sarahemm/laserbox/lasercut_parts/README.md

This directory holds design files for laser cut parts.

prod - Production files to cut actual parts.
test - Test files to cut parts used for testing but not in the final project.
planning - Files used for planning the project, not for actual CAM.
