sarahemm/laserbox/3d/anim_multi.scad

// animation frame data for demo 4
multiframes_circlemissing = [
    [/*[4,3], [4,4],*/ [5,5], [6,6], [7,6], [8,5], [9,4], [9,3], [8,2], [7,1], [6,1], [5,2]],
    [[4,3], /*[4,4], [5,5],*/ [6,6], [7,6], [8,5], [9,4], [9,3], [8,2], [7,1], [6,1], [5,2]],
    [[4,3], [4,4], /*[5,5], [6,6],*/ [7,6], [8,5], [9,4], [9,3], [8,2], [7,1], [6,1], [5,2]],
    [[4,3], [4,4], [5,5], /*[6,6], [7,6],*/ [8,5], [9,4], [9,3], [8,2], [7,1], [6,1], [5,2]],
    [[4,3], [4,4], [5,5], [6,6], /*[7,6], [8,5],*/ [9,4], [9,3], [8,2], [7,1], [6,1], [5,2]],
    [[4,3], [4,4], [5,5], [6,6], [7,6], /*[8,5], [9,4],*/ [9,3], [8,2], [7,1], [6,1], [5,2]],
    [[4,3], [4,4], [5,5], [6,6], [7,6], [8,5], /*[9,4], [9,3],*/ [8,2], [7,1], [6,1], [5,2]],
    [[4,3], [4,4], [5,5], [6,6], [7,6], [8,5], [9,4], /*[9,3], [8,2],*/ [7,1], [6,1], [5,2]],
    [[4,3], [4,4], [5,5], [6,6], [7,6], [8,5], [9,4], [9,3], /*[8,2], [7,1],*/ [6,1], [5,2]],
    [[4,3], [4,4], [5,5], [6,6], [7,6], [8,5], [9,4], [9,3], [8,2], /*[7,1], [6,1],*/ [5,2]]    
];

multiframes_square = [
    [[1,1],[1,2],[1,3],[1,4],[1,5],[1,6]],
    [[1,1],[2,1],[3,1],[4,1],[5,1],[6,1],[7,1],[8,1],[9,1]],
    [[9,1],[9,2],[9,3],[9,4],[9,5],[9,6]],
    [[1,6],[2,6],[3,6],[4,6],[5,6],[6,6],[7,6],[8,6],[9,6]],
    
    [[1,1],[1,2],[1,3],[1,4],[1,5],[1,6]],
    [[1,1],[2,1],[3,1],[4,1],[5,1],[6,1],[7,1],[8,1],[9,1]],
    [[9,1],[9,2],[9,3],[9,4],[9,5],[9,6]],
    [[1,6],[2,6],[3,6],[4,6],[5,6],[6,6],[7,6],[8,6],[9,6]],
    
    [[1,1],[1,2],[1,3],[1,4],[1,5],[1,6]],
    [[1,1],[2,1],[3,1],[4,1],[5,1],[6,1],[7,1],[8,1],[9,1]]
];

multiframes_xy = [
    [[1,1],[1,2],[1,3],[1,4],[1,5],[1,6],  [1,1],[2,1],[3,1],[4,1],[5,1],[6,1]],
    [[2,1],[2,2],[2,3],[2,4],[2,5],[2,6],  [1,2],[2,2],[3,2],[4,2],[5,2],[6,2]],
    [[3,1],[3,2],[3,3],[3,4],[3,5],[3,6],  [1,3],[2,3],[3,3],[4,3],[5,3],[6,3]],
    [[4,1],[4,2],[4,3],[4,4],[4,5],[4,6],  [1,4],[2,4],[3,4],[4,4],[5,4],[6,4]],
    [[5,1],[5,2],[5,3],[5,4],[5,5],[5,6],  [1,5],[2,5],[3,5],[4,5],[5,5],[6,5]],
    
    [[6,1],[6,2],[6,3],[6,4],[6,5],[6,6],  [1,6],[2,6],[3,6],[4,6],[5,6],[6,6]],
    
    [[5,1],[5,2],[5,3],[5,4],[5,5],[5,6],  [1,5],[2,5],[3,5],[4,5],[5,5],[6,5]],
    [[4,1],[4,2],[4,3],[4,4],[4,5],[4,6],  [1,4],[2,4],[3,4],[4,4],[5,4],[6,4]],
    [[3,1],[3,2],[3,3],[3,4],[3,5],[3,6],  [1,3],[2,3],[3,3],[4,3],[5,3],[6,3]],
    [[2,1],[2,2],[2,3],[2,4],[2,5],[2,6],  [1,2],[2,2],[3,2],[4,2],[5,2],[6,2]],
];

multiframes_grid_v = [
    [[1,1],[1,2],[1,3],[1,4],[1,5],[1,6]],
    [[2,1],[2,2],[2,3],[2,4],[2,5],[2,6]],
    [[3,1],[3,2],[3,3],[3,4],[3,5],[3,6]],
    [[4,1],[4,2],[4,3],[4,4],[4,5],[4,6]],
    [[5,1],[5,2],[5,3],[5,4],[5,5],[5,6]],
    
    [[6,1],[6,2],[6,3],[6,4],[6,5],[6,6]],
    
    [[5,1],[5,2],[5,3],[5,4],[5,5],[5,6]],
    [[4,1],[4,2],[4,3],[4,4],[4,5],[4,6]],
    [[3,1],[3,2],[3,3],[3,4],[3,5],[3,6]],
    [[2,1],[2,2],[2,3],[2,4],[2,5],[2,6]],
];

multiframes_grid_h = [
    [[1,1],[2,1],[3,1],[4,1],[5,1],[6,1]],
    [[1,2],[2,2],[3,2],[4,2],[5,2],[6,2]],
    [[1,3],[2,3],[3,3],[4,3],[5,3],[6,3]],
    [[1,4],[2,4],[3,4],[4,4],[5,4],[6,4]],
    [[1,5],[2,5],[3,5],[4,5],[5,5],[6,5]],
    
    [[1,6],[2,6],[3,6],[4,6],[5,6],[6,6]],
    
    [[1,5],[2,5],[3,5],[4,5],[5,5],[6,5]],
    [[1,4],[2,4],[3,4],[4,4],[5,4],[6,4]],
    [[1,3],[2,3],[3,3],[4,3],[5,3],[6,3]],
    [[1,2],[2,2],[3,2],[4,2],[5,2],[6,2]],
];

multiframes_multigrid_v = [
    [[1,1],[1,2],[1,3],[1,4],[1,5],[1,6],  [9,1],[9,2],[9,3],[9,4],[9,5],[9,6]],
    [[2,1],[2,2],[2,3],[2,4],[2,5],[2,6],  [8,1],[8,2],[8,3],[8,4],[8,5],[8,6]],
    [[3,1],[3,2],[3,3],[3,4],[3,5],[3,6],  [7,1],[7,2],[7,3],[7,4],[7,5],[7,6]],
    [[4,1],[4,2],[4,3],[4,4],[4,5],[4,6],  [6,1],[6,2],[6,3],[6,4],[6,5],[6,6]],
    
    [[5,1],[5,2],[5,3],[5,4],[5,5],[5,6]],
    [[5,1],[5,2],[5,3],[5,4],[5,5],[5,6]],
    
    [[4,1],[4,2],[4,3],[4,4],[4,5],[4,6],  [6,1],[6,2],[6,3],[6,4],[6,5],[6,6]],
    [[3,1],[3,2],[3,3],[3,4],[3,5],[3,6],  [7,1],[7,2],[7,3],[7,4],[7,5],[7,6]],
    [[2,1],[2,2],[2,3],[2,4],[2,5],[2,6],  [8,1],[8,2],[8,3],[8,4],[8,5],[8,6]],
    [[1,1],[1,2],[1,3],[1,4],[1,5],[1,6],  [9,1],[9,2],[9,3],[9,4],[9,5],[9,6]],
];

multiframes_multigrid_h = [
    [[1,1],[2,1],[3,1],[4,1],[5,1],[6,1],  [1,9],[2,9],[3,9],[4,9],[5,9],[6,9]],
    [[1,2],[2,2],[3,2],[4,2],[5,2],[6,2],  [1,8],[2,8],[3,8],[4,8],[5,8],[6,8]],
    [[1,3],[2,3],[3,3],[4,3],[5,3],[6,3],  [1,7],[2,7],[3,7],[4,7],[5,7],[6,7]],
    [[1,4],[2,4],[3,4],[4,4],[5,4],[6,4],  [1,6],[2,6],[3,6],[4,6],[5,6],[6,6]],
    
    [[1,5],[2,5],[3,5],[4,5],[5,5],[6,5],  [1,5],[2,5],[3,5],[4,5],[5,5],[6,5]],
    [[1,5],[2,5],[3,5],[4,5],[5,5],[6,5],  [1,5],[2,5],[3,5],[4,5],[5,5],[6,5]],

    [[1,4],[2,4],[3,4],[4,4],[5,4],[6,4],  [1,6],[2,6],[3,6],[4,6],[5,6],[6,6]],
    [[1,3],[2,3],[3,3],[4,3],[5,3],[6,3],  [1,7],[2,7],[3,7],[4,7],[5,7],[6,7]],
    [[1,2],[2,2],[3,2],[4,2],[5,2],[6,2],  [1,8],[2,8],[3,8],[4,8],[5,8],[6,8]],
    [[1,1],[2,1],[3,1],[4,1],[5,1],[6,1],  [1,9],[2,9],[3,9],[4,9],[5,9],[6,9]],
];

multiframes_empty = [
    [],
    [],
    [],
    [],
    [],
    [],
    [],
    [],
    [],
    [],
];
