sarahemm/laserbox/3d/anim_single.scad

// animation frame data for demo 2
v_frames = [
    [6,1],
    [5,2],
    [4,3],
    [3,4],
    [2,5],
    [1,6],
    [2,5],
    [3,4],
    [4,3],
    [5,2]
];

h_frames = [
    [1,1],
    [2,2],
    [3,3],
    [4,4],
    [5,5],
    [6,6],
    [5,1],
    [4,2],
    [2,3],
    [1,4]
];
