sarahemm/laserbox/lasercut_parts/prod/common.scad

function inch_to_mm(inch) = inch * 2.54 * 10;

box_width = inch_to_mm(36);
box_height = inch_to_mm(36);
box_depth = inch_to_mm(24);

plate_height = inch_to_mm(6);

material_thickness = 6;
