sarahemm/laserbox/hardware/muxboard/laserbox-muxboard.brd

## EAGLE design hardware/muxboard/laserbox-muxboard.brd (2017-01-30)

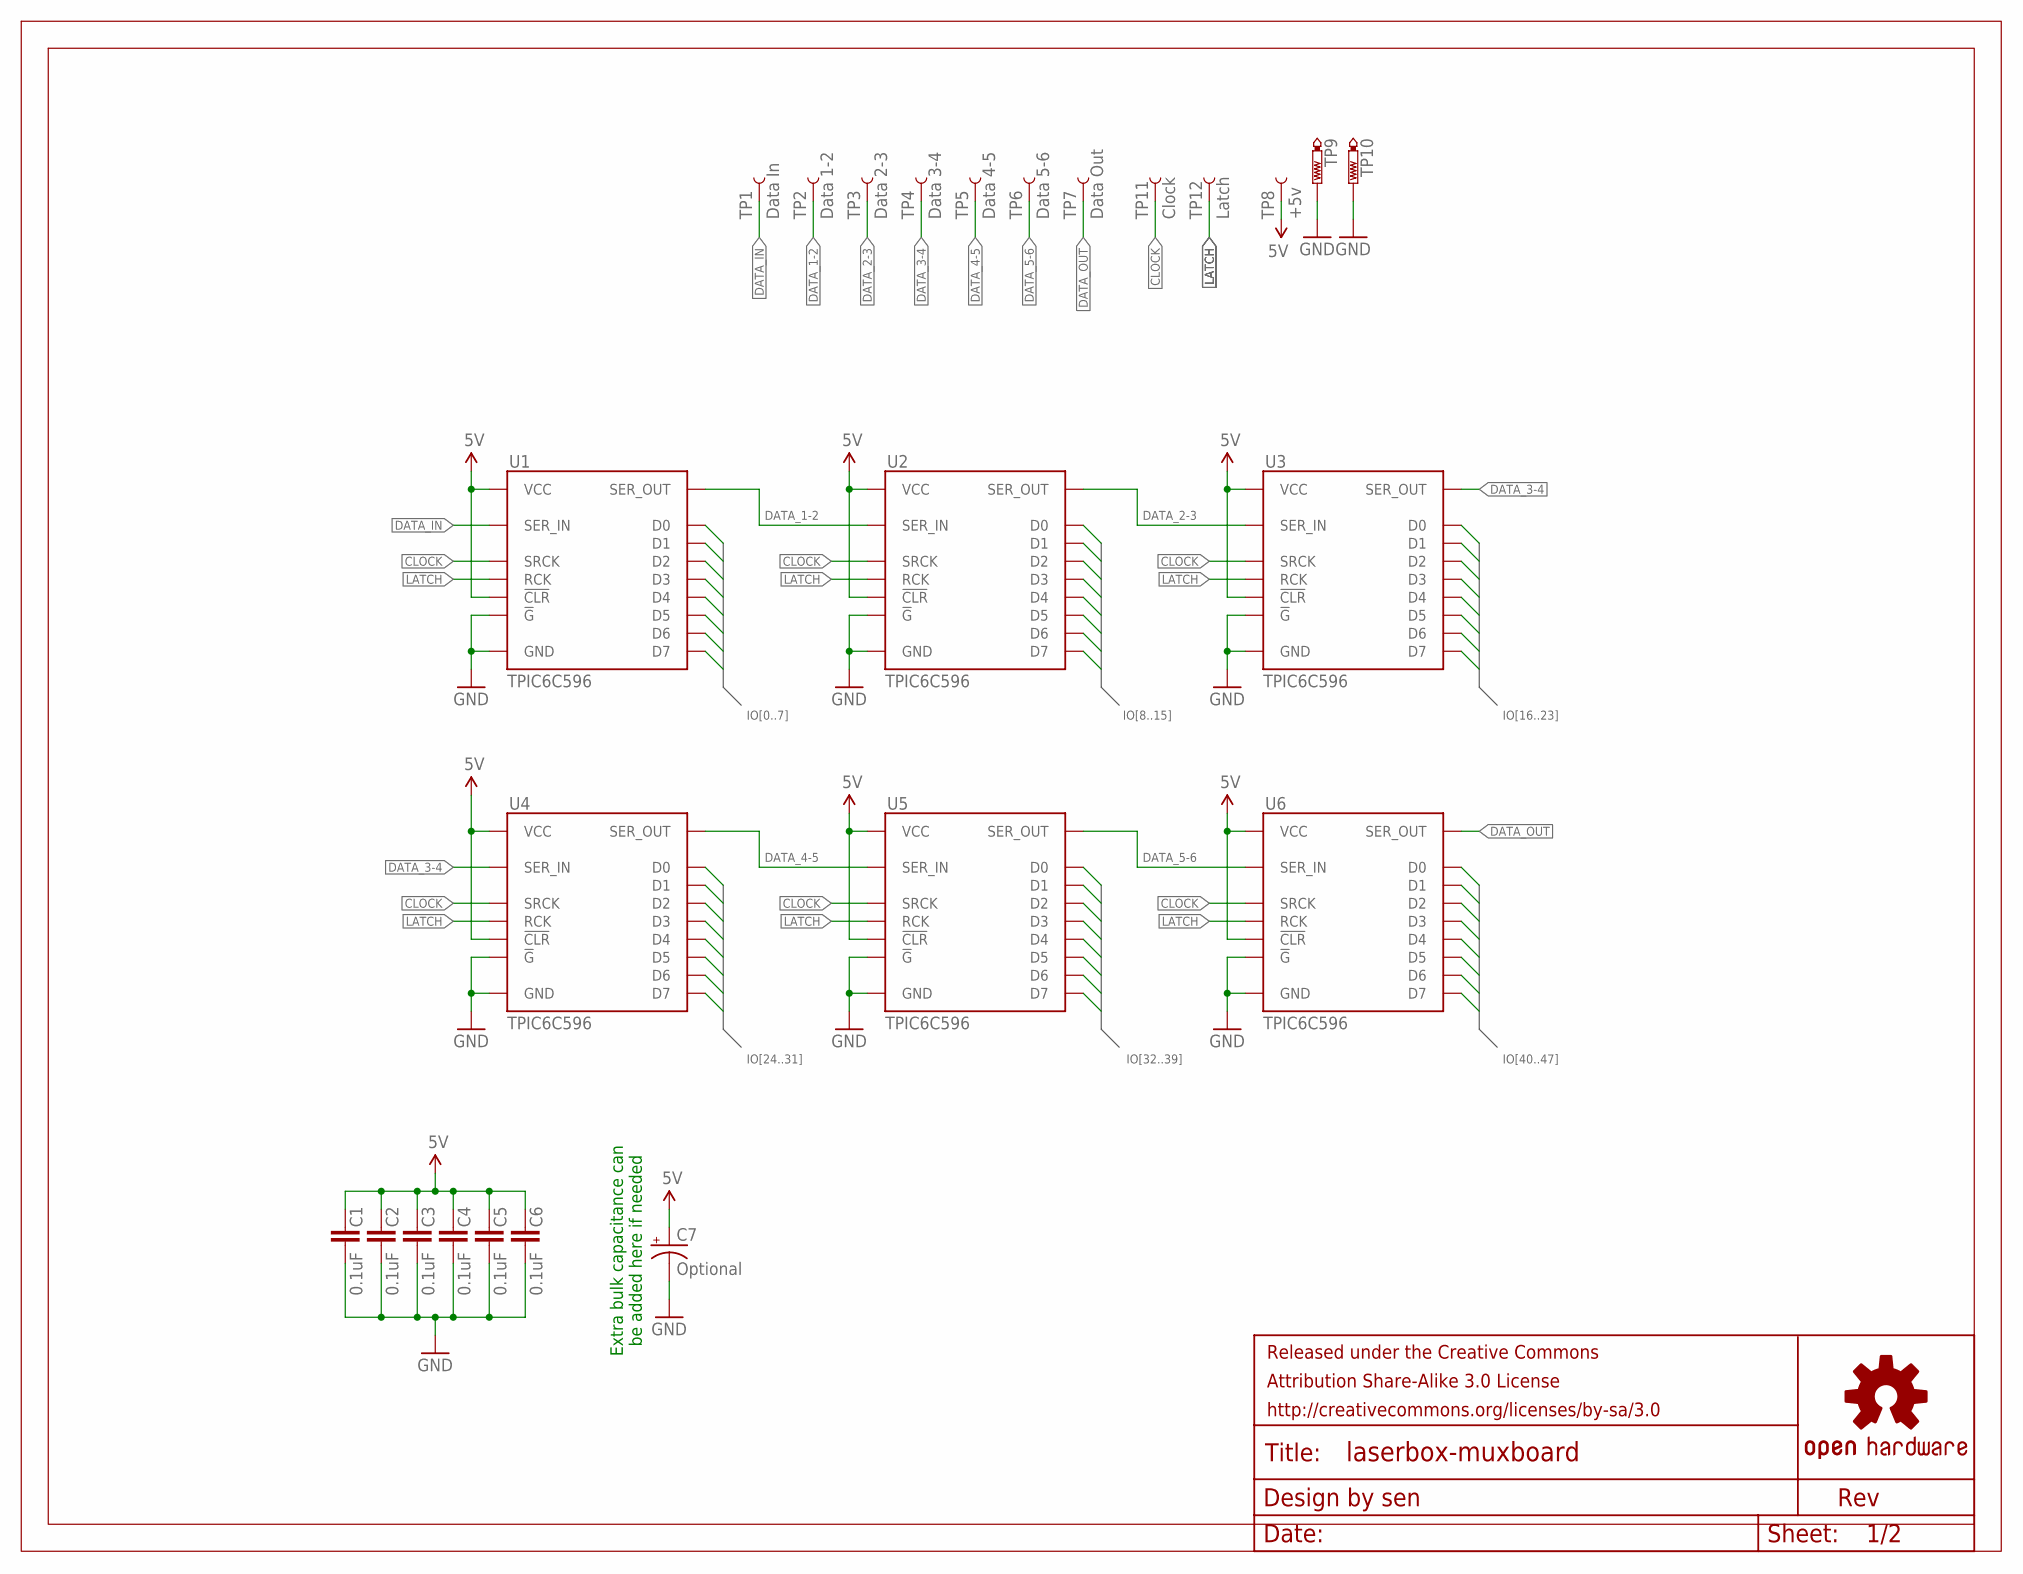
[picture p1: schematic laserbox-muxboard.sch, sheet 1, Logic]

Parts:
C1, C2, C3, C4, C5, C6: 0.1uF; 0603-CAP
C7: Optional; CPOL-RADIAL-10UF-25V
FRAME1: FRAME-LETTER-GRID-OSHW-SENOSHW-LOGO-L; OSHW-LOGO-L
TP1: Data In; PAD.03X.05
TP2: Data 1-2; PAD.03X.05
TP3: Data 2-3; PAD.03X.05
TP4: Data 3-4; PAD.03X.05
TP5: Data 4-5; PAD.03X.05
TP6: Data 5-6; PAD.03X.05
TP7: Data Out; PAD.03X.05
TP8: +5v; PAD.03X.05
TP9, TP10: GND; P1-13
TP11: Clock; PAD.03X.05
TP12: Latch; PAD.03X.05
U1, U2, U3, U4, U5, U6: TPIC6C596; SO016

Connections:
5V: C1.1, C2.1, C3.1, C4.1, C5.1, C6.1, C7.1 (+), TP8.P$1, U1.1 (VCC), U1.7 (!CLR), U2.1 (VCC), U2.7 (!CLR), U3.1 (VCC), U3.7 (!CLR), U4.1 (VCC), U4.7 (!CLR), U5.1 (VCC), U5.7 (!CLR), U6.1 (VCC), U6.7 (!CLR); also elsewhere on the board
CLOCK: TP11.P$1, U1.15 (SRCK), U2.15 (SRCK), U3.15 (SRCK), U4.15 (SRCK), U5.15 (SRCK), U6.15 (SRCK); also elsewhere on the board
DATA_1-2: TP2.P$1, U1.9 (SER_OUT), U2.2 (SER_IN)
DATA_2-3: TP3.P$1, U2.9 (SER_OUT), U3.2 (SER_IN)
DATA_3-4: TP4.P$1, U3.9 (SER_OUT), U4.2 (SER_IN)
DATA_4-5: TP5.P$1, U4.9 (SER_OUT), U5.2 (SER_IN)
DATA_5-6: TP6.P$1, U5.9 (SER_OUT), U6.2 (SER_IN)
DATA_IN: TP1.P$1, U1.2 (SER_IN); also elsewhere on the board
DATA_OUT: TP7.P$1, U6.9 (SER_OUT); also elsewhere on the board
GND: C1.2, C2.2, C3.2, C4.2, C5.2, C6.2, C7.2 (-), TP9.TP, TP10.TP, U1.8 (!G), U1.16 (GND), U2.8 (!G), U2.16 (GND), U3.8 (!G), U3.16 (GND), U4.8 (!G), U4.16 (GND), U5.8 (!G), U5.16 (GND), U6.8 (!G), U6.16 (GND); also elsewhere on the board
IO0: U1.3 (D0); also elsewhere on the board
IO1: U1.4 (D1); also elsewhere on the board
IO2: U1.5 (D2); also elsewhere on the board
IO3: U1.6 (D3); also elsewhere on the board
IO4: U1.11 (D4); also elsewhere on the board
IO5: U1.12 (D5); also elsewhere on the board
IO6: U1.13 (D6); also elsewhere on the board
IO7: U1.14 (D7); also elsewhere on the board
IO8: U2.3 (D0); also elsewhere on the board
IO9: U2.4 (D1); also elsewhere on the board
IO10: U2.5 (D2); also elsewhere on the board
IO11: U2.6 (D3); also elsewhere on the board
IO12: U2.11 (D4); also elsewhere on the board
IO13: U2.12 (D5); also elsewhere on the board
IO14: U2.13 (D6); also elsewhere on the board
IO15: U2.14 (D7); also elsewhere on the board
IO16: U3.3 (D0); also elsewhere on the board
IO17: U3.4 (D1); also elsewhere on the board
IO18: U3.5 (D2); also elsewhere on the board
IO19: U3.6 (D3); also elsewhere on the board
IO20: U3.11 (D4); also elsewhere on the board
IO21: U3.12 (D5); also elsewhere on the board
IO22: U3.13 (D6); also elsewhere on the board
IO23: U3.14 (D7); also elsewhere on the board
IO24: U4.3 (D0); also elsewhere on the board
IO25: U4.4 (D1); also elsewhere on the board
IO26: U4.5 (D2); also elsewhere on the board
IO27: U4.6 (D3); also elsewhere on the board
IO28: U4.11 (D4); also elsewhere on the board
IO29: U4.12 (D5); also elsewhere on the board
IO30: U4.13 (D6); also elsewhere on the board
IO31: U4.14 (D7); also elsewhere on the board
IO32: U5.3 (D0); also elsewhere on the board
IO33: U5.4 (D1); also elsewhere on the board
IO34: U5.5 (D2); also elsewhere on the board
IO35: U5.6 (D3); also elsewhere on the board
IO36: U5.11 (D4); also elsewhere on the board
IO37: U5.12 (D5); also elsewhere on the board
IO38: U5.13 (D6); also elsewhere on the board
IO39: U5.14 (D7); also elsewhere on the board
IO40: U6.3 (D0); also elsewhere on the board
IO41: U6.4 (D1); also elsewhere on the board
IO42: U6.5 (D2); also elsewhere on the board
IO43: U6.6 (D3); also elsewhere on the board
IO44: U6.11 (D4); also elsewhere on the board
IO45: U6.12 (D5); also elsewhere on the board
IO46: U6.13 (D6); also elsewhere on the board
IO47: U6.14 (D7); also elsewhere on the board
LATCH: TP12.P$1, U1.10 (RCK), U2.10 (RCK), U3.10 (RCK), U4.10 (RCK), U5.10 (RCK), U6.10 (RCK); also elsewhere on the board

Notes on the sheet:
Extra bulk capacitance can be added here if needed

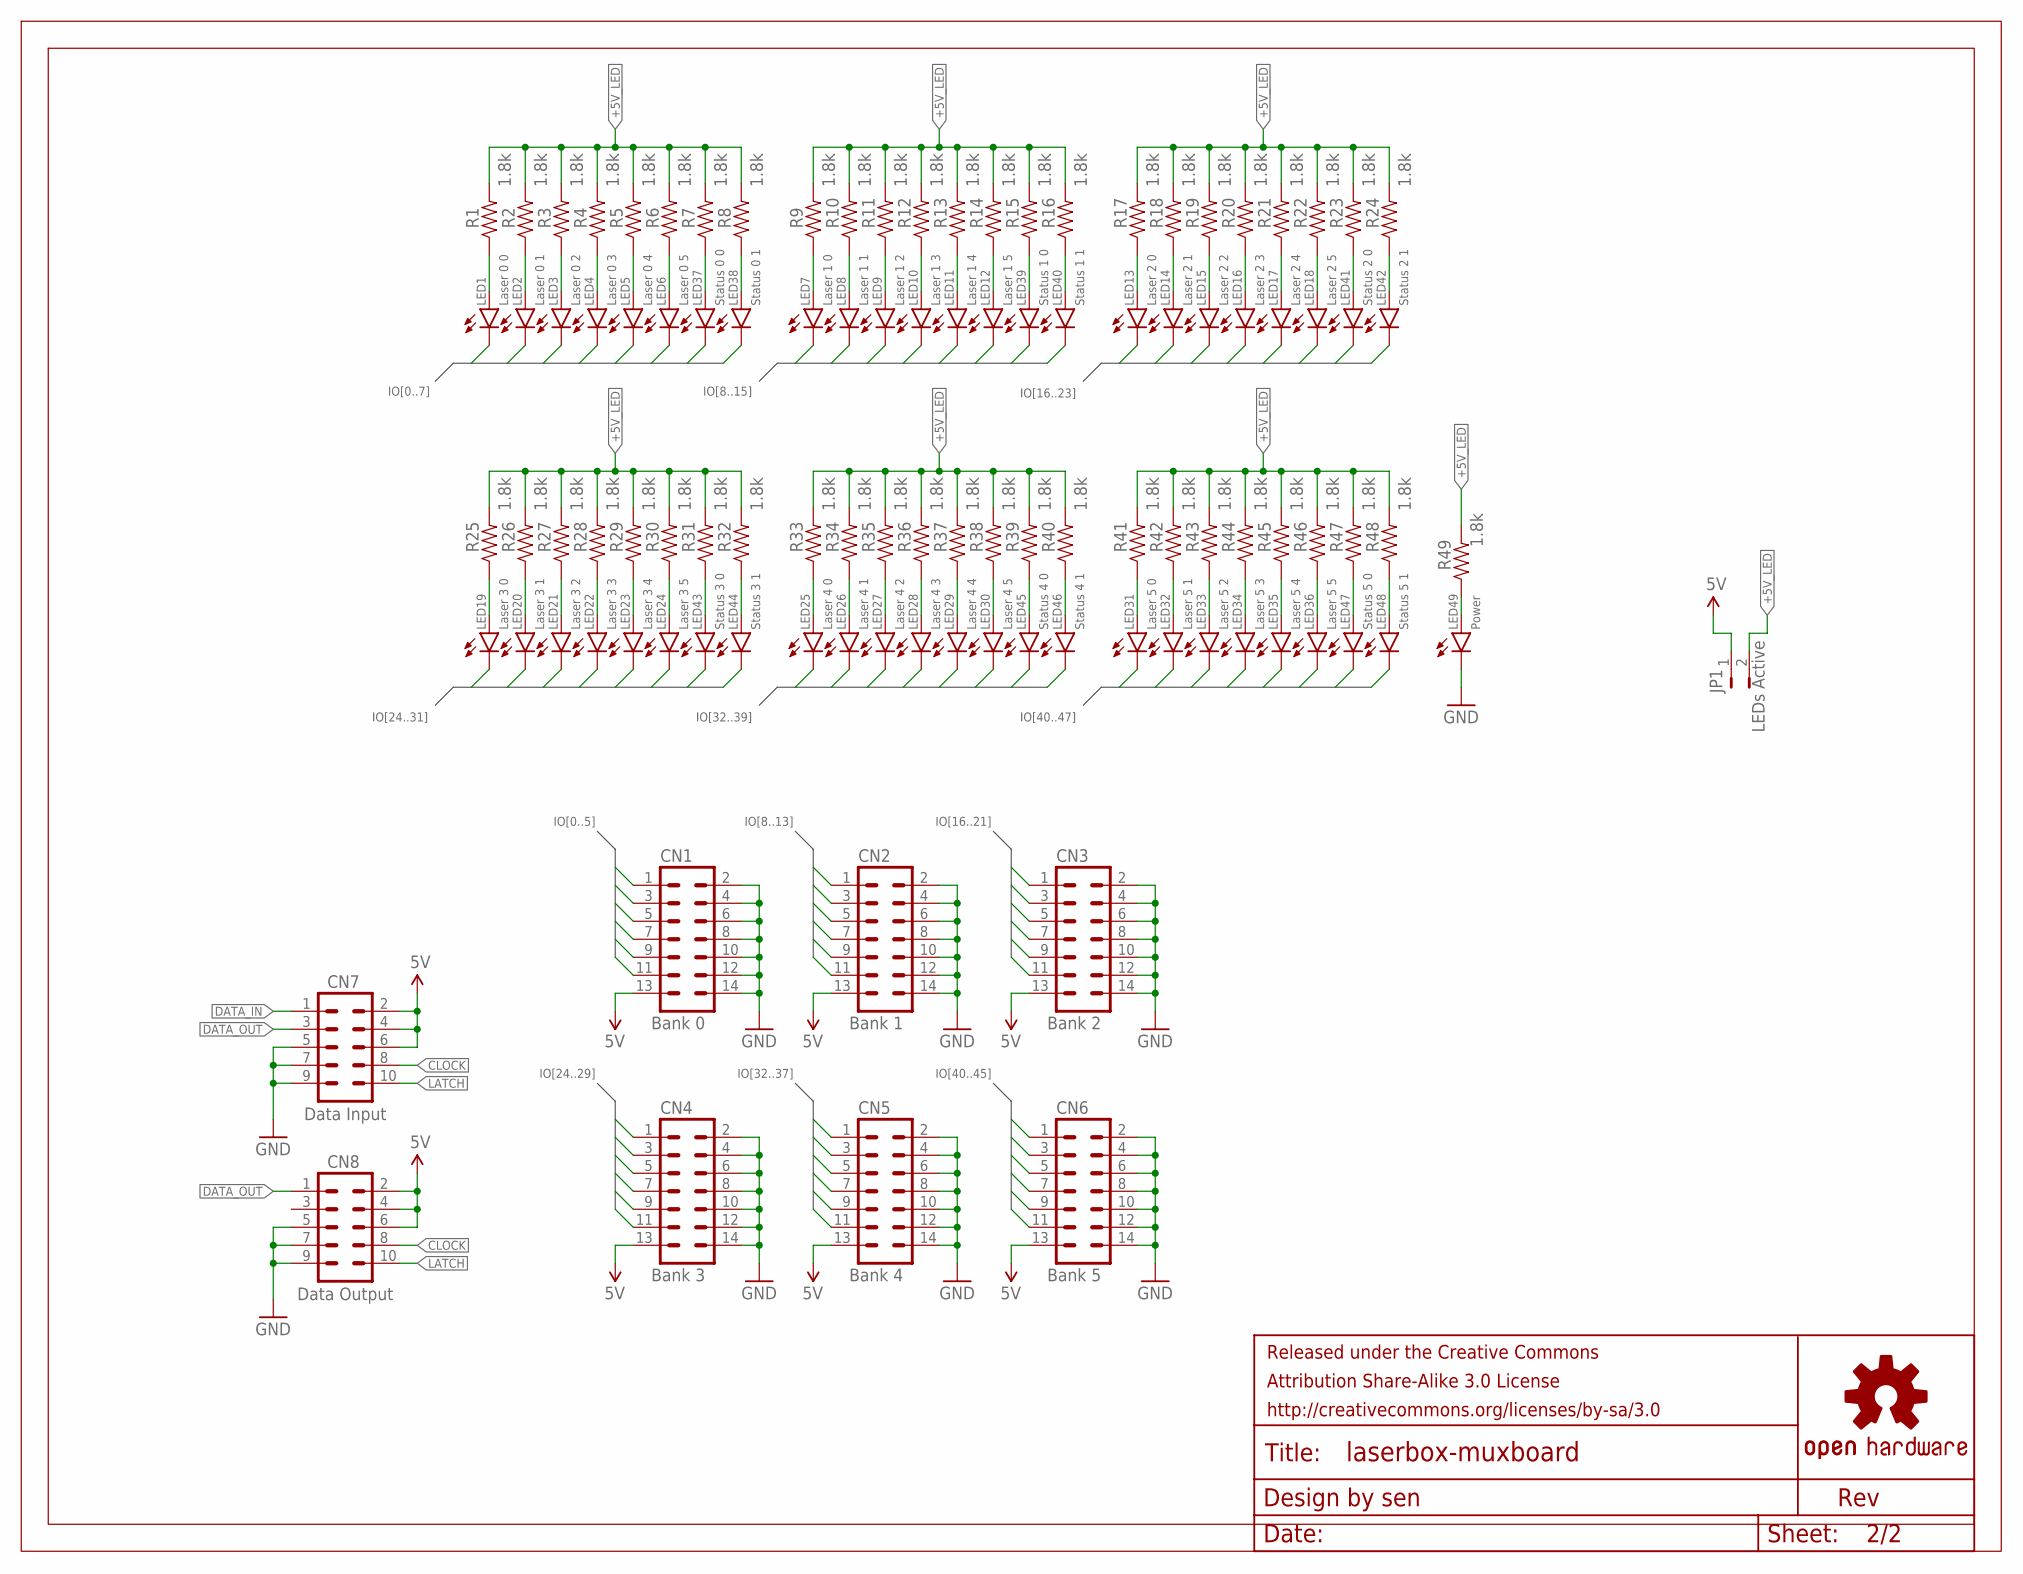
[picture p2: schematic laserbox-muxboard.sch, sheet 2, Status + I/O]

Parts:
CN1: Bank 0; 2X7-SHROUDED_LOCK
CN2: Bank 1; 2X7-SHROUDED_LOCK
CN3: Bank 2; 2X7-SHROUDED_LOCK
CN4: Bank 3; 2X7-SHROUDED_LOCK
CN5: Bank 4; 2X7-SHROUDED_LOCK
CN6: Bank 5; 2X7-SHROUDED_LOCK
CN7: Data Input; 2X5-SHROUDED_LOCK
CN8: Data Output; 2X5-SHROUDED_LOCK
FRAME2: FRAME-LETTER-GRID-OSHW-SENOSHW-LOGO-L; OSHW-LOGO-L
JP1: LEDs Active; PTH-JUMPER-2-NO_NO_SILK
LED1: Laser 0 0; LED3MM
LED2: Laser 0 1; LED3MM
LED3: Laser 0 2; LED3MM
LED4: Laser 0 3; LED3MM
LED5: Laser 0 4; LED3MM
LED6: Laser 0 5; LED3MM
LED7: Laser 1 0; LED3MM
LED8: Laser 1 1; LED3MM
LED9: Laser 1 2; LED3MM
LED10: Laser 1 3; LED3MM
LED11: Laser 1 4; LED3MM
LED12: Laser 1 5; LED3MM
LED13: Laser 2 0; LED3MM
LED14: Laser 2 1; LED3MM
LED15: Laser 2 2; LED3MM
LED16: Laser 2 3; LED3MM
LED17: Laser 2 4; LED3MM
LED18: Laser 2 5; LED3MM
LED19: Laser 3 0; LED3MM
LED20: Laser 3 1; LED3MM
LED21: Laser 3 2; LED3MM
LED22: Laser 3 3; LED3MM
LED23: Laser 3 4; LED3MM
LED24: Laser 3 5; LED3MM
LED25: Laser 4 0; LED3MM
LED26: Laser 4 1; LED3MM
LED27: Laser 4 2; LED3MM
LED28: Laser 4 3; LED3MM
LED29: Laser 4 4; LED3MM
LED30: Laser 4 5; LED3MM
LED31: Laser 5 0; LED3MM
LED32: Laser 5 1; LED3MM
LED33: Laser 5 2; LED3MM
LED34: Laser 5 3; LED3MM
LED35: Laser 5 4; LED3MM
LED36: Laser 5 5; LED3MM
LED37: Status 0 0; LED3MM
LED38: Status 0 1; LED3MM
LED39: Status 1 0; LED3MM
LED40: Status 1 1; LED3MM
LED41: Status 2 0; LED3MM
LED42: Status 2 1; LED3MM
LED43: Status 3 0; LED3MM
LED44: Status 3 1; LED3MM
LED45: Status 4 0; LED3MM
LED46: Status 4 1; LED3MM
LED47: Status 5 0; LED3MM
LED48: Status 5 1; LED3MM
LED49: Power; LED3MM
R1, R2, R3, R4, R5, R6, R7, R8, R9, R10, R11, R12, R13, R14, R15, R16, R17, R18, R19, R20, R21, R22, R23, R24, R25, R26, R27, R28, R29, R30, R31, R32, R33, R34, R35, R36, R37, R38, R39, R40, R41, R42, R43, R44, R45, R46, R47, R48, R49: 1.8k; 0603-RES

Connections:
5V: CN1.13, CN2.13, CN3.13, CN4.13, CN5.13, CN6.13, CN7.2, CN7.4, CN7.6, CN8.2, CN8.4, CN8.6, JP1.1; also elsewhere on the board
+5V_LED: JP1.2, R1.2, R2.2, R3.2, R4.2, R5.2, R6.2, R7.2, R8.2, R9.2, R10.2, R11.2, R12.2, R13.2, R14.2, R15.2, R16.2, R17.2, R18.2, R19.2, R20.2, R21.2, R22.2, R23.2, R24.2, R25.2, R26.2, R27.2, R28.2, R29.2, R30.2, R31.2, R32.2, R33.2, R34.2, R35.2, R36.2, R37.2, R38.2, R39.2, R40.2, R41.2, R42.2, R43.2, R44.2, R45.2, R46.2, R47.2, R48.2, R49.2
CLOCK: CN7.8, CN8.8; also elsewhere on the board
DATA_IN: CN7.1; also elsewhere on the board
DATA_OUT: CN7.3, CN8.1; also elsewhere on the board
GND: CN1.2, CN1.4, CN1.6, CN1.8, CN1.10, CN1.12, CN1.14, CN2.2, CN2.4, CN2.6, CN2.8, CN2.10, CN2.12, CN2.14, CN3.2, CN3.4, CN3.6, CN3.8, CN3.10, CN3.12, CN3.14, CN4.2, CN4.4, CN4.6, CN4.8, CN4.10, CN4.12, CN4.14, CN5.2, CN5.4, CN5.6, CN5.8, CN5.10, CN5.12, CN5.14, CN6.2, CN6.4, CN6.6, CN6.8, CN6.10, CN6.12, CN6.14, CN7.5, CN7.7, CN7.9, CN8.5, CN8.7, CN8.9, LED49.K (C); also elsewhere on the board
IO0: CN1.1, LED1.K (C); also elsewhere on the board
IO1: CN1.3, LED2.K (C); also elsewhere on the board
IO2: CN1.5, LED3.K (C); also elsewhere on the board
IO3: CN1.7, LED4.K (C); also elsewhere on the board
IO4: CN1.9, LED5.K (C); also elsewhere on the board
IO5: CN1.11, LED6.K (C); also elsewhere on the board
IO6: LED37.K (C); also elsewhere on the board
IO7: LED38.K (C); also elsewhere on the board
IO8: CN2.1, LED7.K (C); also elsewhere on the board
IO9: CN2.3, LED8.K (C); also elsewhere on the board
IO10: CN2.5, LED9.K (C); also elsewhere on the board
IO11: CN2.7, LED10.K (C); also elsewhere on the board
IO12: CN2.9, LED11.K (C); also elsewhere on the board
IO13: CN2.11, LED12.K (C); also elsewhere on the board
IO14: LED39.K (C); also elsewhere on the board
IO15: LED40.K (C); also elsewhere on the board
IO16: CN3.1, LED13.K (C); also elsewhere on the board
IO17: CN3.3, LED14.K (C); also elsewhere on the board
IO18: CN3.5, LED15.K (C); also elsewhere on the board
IO19: CN3.7, LED16.K (C); also elsewhere on the board
IO20: CN3.9, LED17.K (C); also elsewhere on the board
IO21: CN3.11, LED18.K (C); also elsewhere on the board
IO22: LED41.K (C); also elsewhere on the board
IO23: LED42.K (C); also elsewhere on the board
IO24: CN4.1, LED19.K (C); also elsewhere on the board
IO25: CN4.3, LED20.K (C); also elsewhere on the board
IO26: CN4.5, LED21.K (C); also elsewhere on the board
IO27: CN4.7, LED22.K (C); also elsewhere on the board
IO28: CN4.9, LED23.K (C); also elsewhere on the board
IO29: CN4.11, LED24.K (C); also elsewhere on the board
IO30: LED43.K (C); also elsewhere on the board
IO31: LED44.K (C); also elsewhere on the board
IO32: CN5.1, LED25.K (C); also elsewhere on the board
IO33: CN5.3, LED26.K (C); also elsewhere on the board
IO34: CN5.5, LED27.K (C); also elsewhere on the board
IO35: CN5.7, LED28.K (C); also elsewhere on the board
IO36: CN5.9, LED29.K (C); also elsewhere on the board
IO37: CN5.11, LED30.K (C); also elsewhere on the board
IO38: LED45.K (C); also elsewhere on the board
IO39: LED46.K (C); also elsewhere on the board
IO40: CN6.1, LED31.K (C); also elsewhere on the board
IO41: CN6.3, LED32.K (C); also elsewhere on the board
IO42: CN6.5, LED33.K (C); also elsewhere on the board
IO43: CN6.7, LED34.K (C); also elsewhere on the board
IO44: CN6.9, LED35.K (C); also elsewhere on the board
IO45: CN6.11, LED36.K (C); also elsewhere on the board
IO46: LED47.K (C); also elsewhere on the board
IO47: LED48.K (C); also elsewhere on the board
LATCH: CN7.10, CN8.10; also elsewhere on the board
LED1_R: LED1.A, R1.1
LED2_R: LED2.A, R2.1
LED3_R: LED3.A, R3.1
LED4_R: LED4.A, R4.1
LED5_R: LED5.A, R5.1
LED6_R: LED6.A, R6.1
LED7_R: LED7.A, R9.1
LED8_R: LED8.A, R10.1
LED9_R: LED9.A, R11.1
LED10_R: LED10.A, R12.1
LED11_R: LED11.A, R13.1
LED12_R: LED12.A, R14.1
LED13_R: LED13.A, R17.1
LED14_R: LED14.A, R18.1
LED15_R: LED15.A, R19.1
LED16_R: LED16.A, R20.1
LED17_R: LED17.A, R21.1
LED18_R: LED18.A, R22.1
LED19_R: LED19.A, R25.1
LED20_R: LED20.A, R26.1
LED21_R: LED21.A, R27.1
LED22_R: LED22.A, R28.1
LED23_R: LED23.A, R29.1
LED24_R: LED24.A, R30.1
LED25_R: LED25.A, R33.1
LED26_R: LED26.A, R34.1
LED27_R: LED27.A, R35.1
LED28_R: LED28.A, R36.1
LED29_R: LED29.A, R37.1
LED30_R: LED30.A, R38.1
LED31_R: LED31.A, R41.1
LED32_R: LED32.A, R42.1
LED33_R: LED33.A, R43.1
LED34_R: LED34.A, R44.1
LED35_R: LED35.A, R45.1
LED36_R: LED36.A, R46.1
LED37_R: LED37.A, R7.1
LED38_R: LED38.A, R8.1
LED39_R: LED39.A, R15.1
LED40_R: LED40.A, R16.1
LED41_R: LED41.A, R23.1
LED42_R: LED42.A, R24.1
LED43_R: LED43.A, R31.1
LED44_R: LED44.A, R32.1
LED45_R: LED45.A, R39.1
LED46_R: LED46.A, R40.1
LED47_R: LED47.A, R47.1
LED48_R: LED48.A, R48.1
LED49_R: LED49.A, R49.1

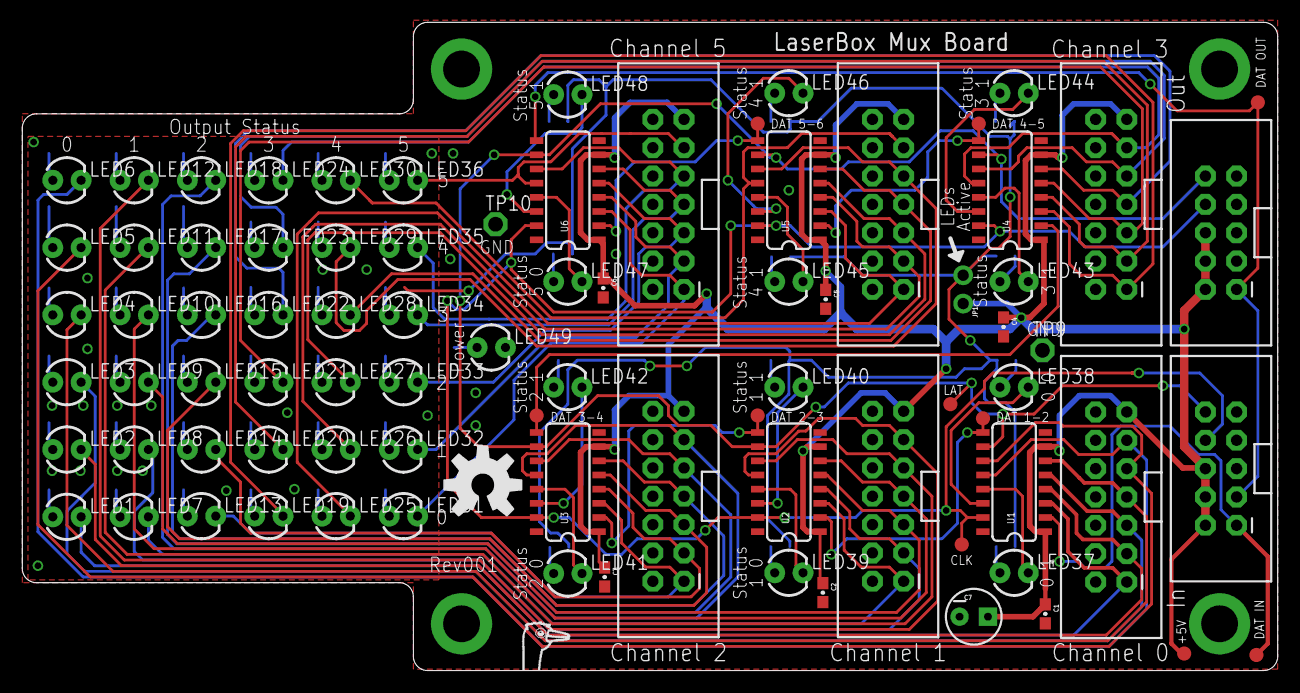
[picture p3: board laserbox-muxboard.brd from above]

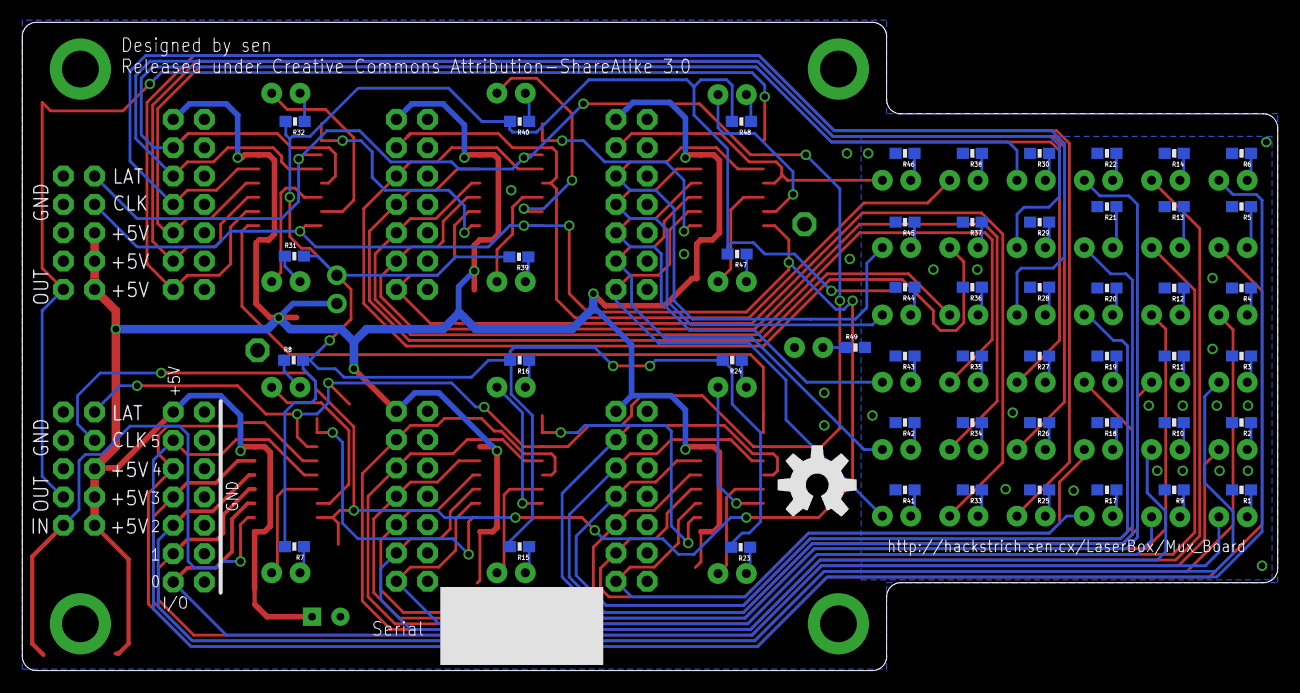
[picture p4: board laserbox-muxboard.brd from below]

Board: 2 copper layers, 112.5 x 58.1 mm, 135 parts (50 on the bottom side), 109 nets.

Other parts of the board:
U$1: STRICH-LOGO-R
