sarahemm/laserbox/(commit log)

2017-01-18 Adding current 3D model of the laserbox project.
    [laserbox.scad]
2017-01-18 Added gesture sensor opening.
    [laserbox.scad]
2017-01-18 Splitting out animation data into separate files.
    [anim_multi.scad, anim_single.scad, laserbox.scad]
2017-01-27 Completed and checklisted LaserBox Mux Board Rev001.
    [laserbox-muxboard.sch]
2017-01-28 Adding start at a board layout.
    [laserbox-muxboard.brd, laserbox-muxboard.sch]
2017-01-29 Routing continues.
    [laserbox-muxboard.brd, laserbox-muxboard.sch]
2017-01-29 Commit before I try changing the data connectors around.
    [laserbox-muxboard.brd]
2017-01-29 Routing continues, 27 airwires left, almost entirely 5V/5V_LED.
    [laserbox-muxboard.brd]
2017-01-30 Routing continues, 9 airwires left to route.
    [laserbox-muxboard.brd]
2017-01-30 Board routing and checklist complete.
    [laserbox-muxboard.brd, laserbox-muxboard.sch]
2017-03-04 Adding checklisted CAM files.
    [laserbox-muxboard.drills.xln]
2017-03-04 Adding laser cut test plate design file.
    [laserbox_test_plate.scad]
2017-03-16 Adding complete/working LaserBox animation pattern editor.
2017-03-19 Mid-work on ability to attach to a live LaserBox and display changes in real time.
2017-03-19 Finished feature to attach to live LaserBox, now works on both planes.
2017-03-22 Added ability to export to Pattern v2 format.
    Can now save as v1 or export to v2, but only load v1 currently.
    Eventually would be nice to eliminate v1 altogether but not really required.
2017-04-02 New frame now starts with copy of previously selected frame.
2017-04-04 Adding current version of the firmware, is a work in progress but functional.
2017-04-04 Moving the test file to a separate directory to make it clear it's not part of the final project.
    [laserbox_test_plate.scad]
2017-04-05 Work-in-progress laser cut part designs for the structure.
    [box_rail.scad, common.scad, laserbox_test_plate.scad, left_vertical_plate.scad, right_vertical_plate.scad, top_plate.scad]
2017-04-06 Completed first revision of all the laser cut parts.
    Most of these probably still need major work, but it's a start.
    [bottom_plate.scad, front.scad, laser_plate.scad, left_vertical_plate.scad]
2017-04-06 Added material amounts to each file. ~40 square feet total, yikes!
    [bottom_plate.scad, box_rail.scad, front.scad, laser_plate.scad, left_vertical_plate.scad, right_vertical_plate.scad, top_plate.scad]
2017-04-07 Added Fog subsystem, currently just supports a fan test.
2017-04-15 Added laser sequence test and ability to set clock.
2017-04-18 Split out left/right vert rails into separate files to increase packing efficiency on panels.
    [left_vertical_plate.scad, left_vertical_rails.scad, right_vertical_plate.scad, right_vertical_rails.scad]
2017-04-18 Adding material usage planning file.
    [panel_layout.scad]
