sarahemm/laserbox/(notices)

Notices in the files:
hardware/muxboard/laserbox-muxboard.brd:
Released under Creative Commons Attribution-ShareAlike 3.0
parts and their libraries:
SparkFun-DigitalIC: Licensing: Creative Commons ShareAlike 4.0 International - https://creativecommons.org/licenses/by-sa/4.0
logos-sen: Released under the Creative Commons Attribution Share-Alike 3.0 License
logos-sen: http://creativecommons.org/licenses/by-sa/3.0
